Sablewolf/DiyDesolderingStation/README.md

DiyDesolderingStation
=====================
This repo is for the BoM and wiring diagram for my diy desoldering station.
Also added a pdf copy of my build notes
