Sablewolf/DiyDesolderingStation/BoM_Diy_Desoldering_Station.ods

BoM for diy desoldering station.
6' vinyl tubing | $1.92 | Local Hardware Store
1/2" threaded PVC Sch40 end cap | $0.77 | Lowe's
1/2" threaded PVC Sch40 extender | $0.67 | Lowe's
1/4"X 1/2" Nylon barb | $1.04 | Lowe's
Radio Shack desoldering iron | $14.99 | http://www.radioshack.com/product/index.jsp?productId=2062731
ATX brake out board | $13.80 | http://www.seeedstudio.com/depot/atx-breakout-board-bench-power-supply-p-1222.html
SoB ATX brake out case | $4.00 | http://www.seeedstudio.com/depot/atx-breakout-board-v11-acrylic-case-v1-dp10080-p-1288.html
Foot pedal | $5.00 | http://www.seeedstudio.com/depot/foot-switch-tfs201-p-665.html
Quick Steel | $6.99 | O'Reillys Auto Parts
Vacuum pump | $14.95 | https://www.sparkfun.com/products/10398
Steel wool | $3.99 | Local Hardware Store
Total | $68.12
Things I had on hand:
Molex Power extension cable
New used auto fuel filter
ATX power supply
