Sablewolf/DiyDesolderingStation/Desoldering_Station.sch

## EAGLE design Desoldering_Station.sch (2013-11-11)

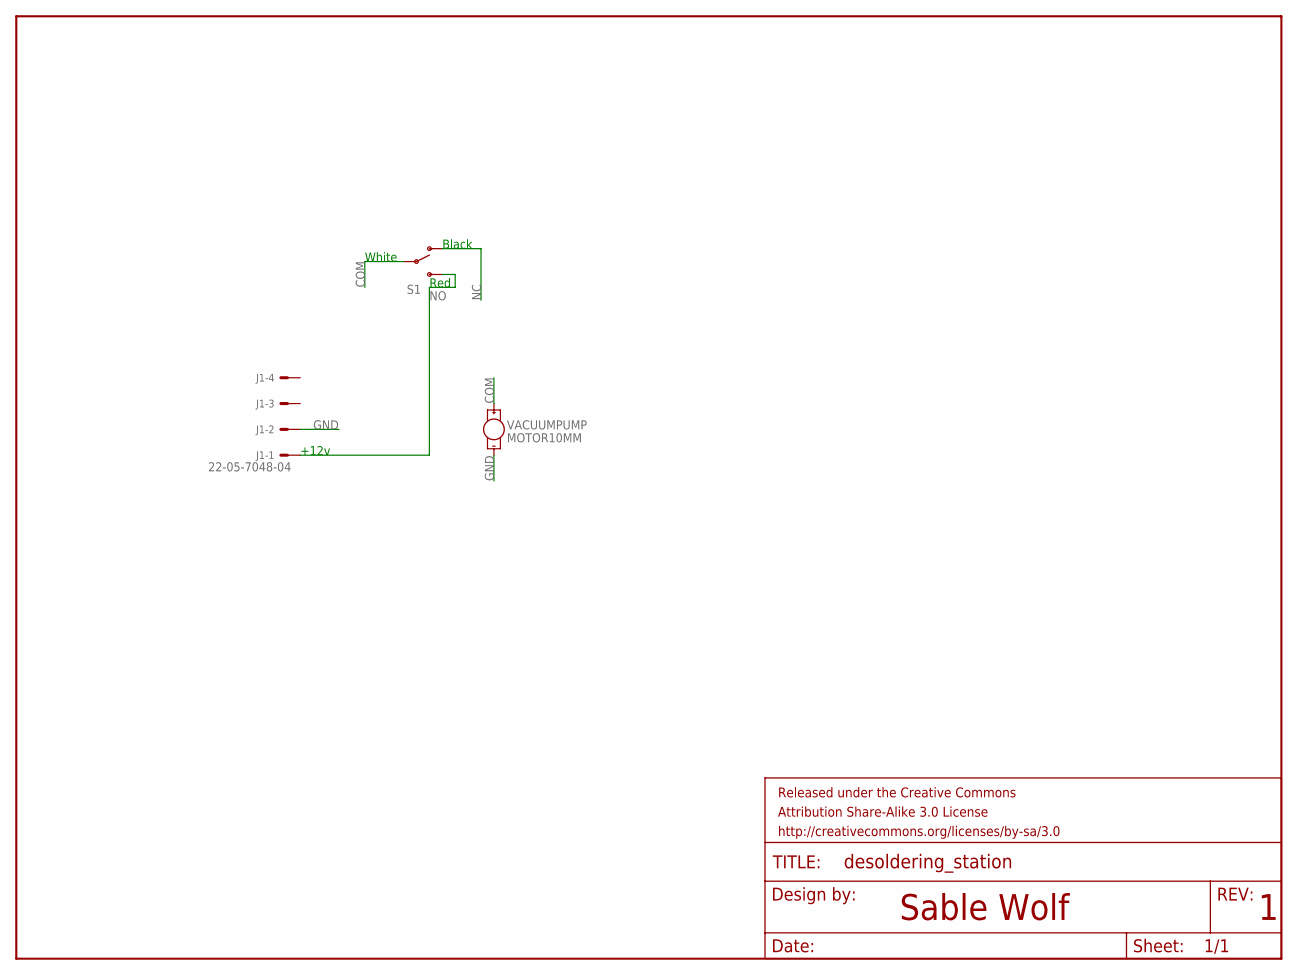
[picture p1: schematic Desoldering_Station.sch]

Parts:
FRAME1: FRAME-LETTER; CREATIVE_COMMONS
J1: 22-05-7048-04; 7395-04
S1: SWITCH-SPDTKIT; SWITCH-SPDT_KIT
VACUUMPUMP: MOTOR10MM; VIBE-MOTOR-10MM

Connections:
COM: S1.2, VACUUMPUMP.+
GND: J1.2, VACUUMPUMP.-
NC: S1.1 (O)
NO: J1.1, S1.3 (S)

Notes on the sheet:
White
Black
Red
+12v
Sable Wolf
